bobricius/AtTiny85-Programming-Shield/README.md

AtTiny85-Programming-Shield
===========================

For HVSP programing you need externall 12V power and small wire between Attiny85 pin2 and Arduino D9
(bug on PCB)
