bobricius/AtTiny85-Programming-Shield/V1/ATTINYProgrammer.brd

## EAGLE design V1/ATTINYProgrammer.brd (2014-12-17)

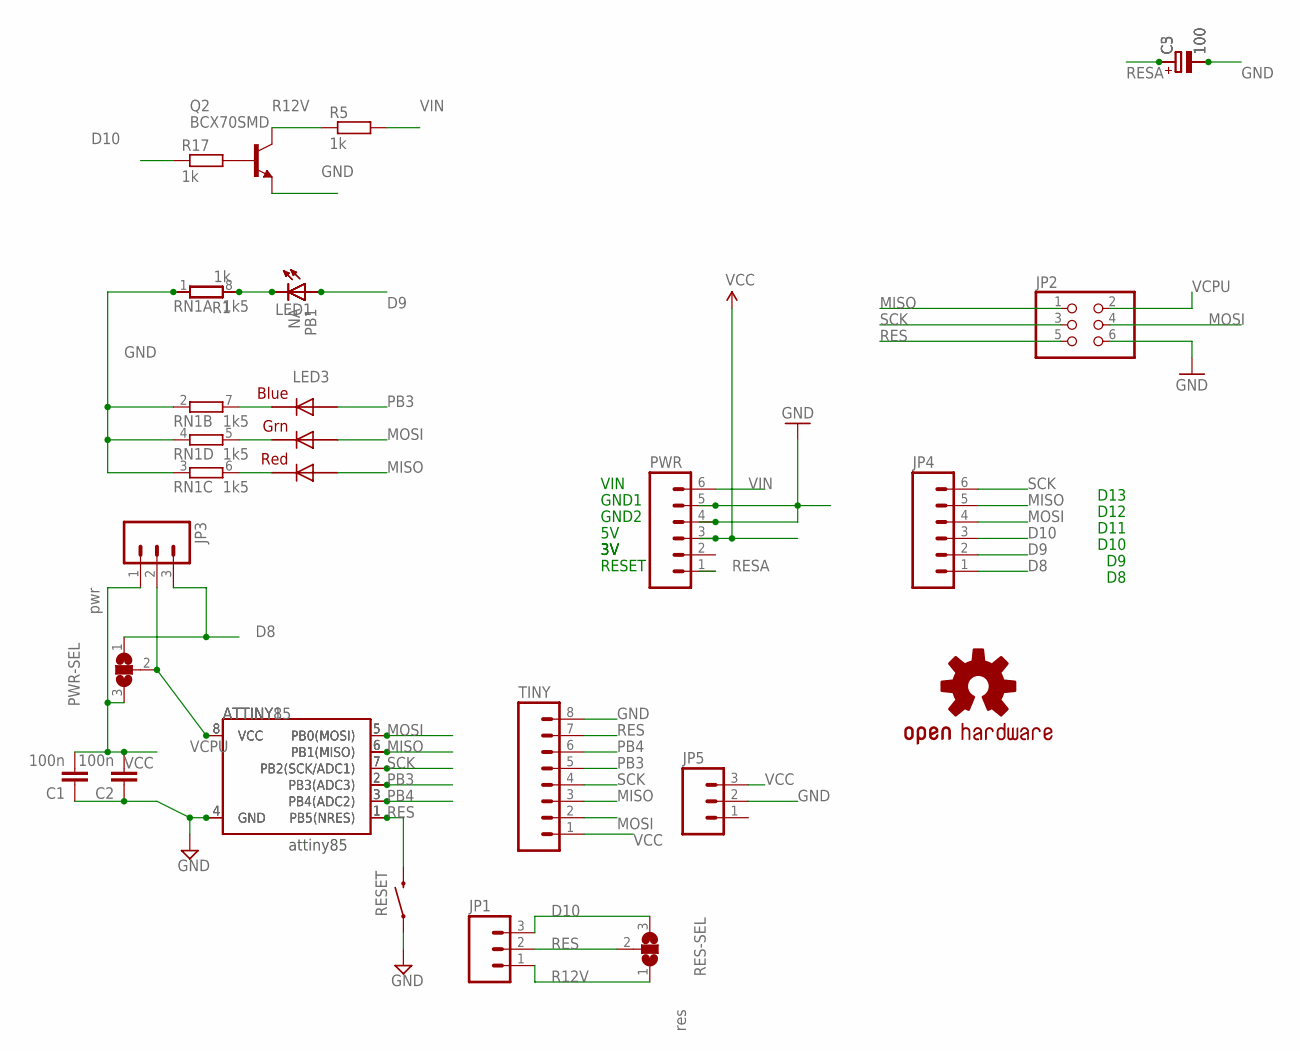
[picture p1: schematic ATTINYProgrammer.sch]

Parts:
ATTINY1: ATTINY45; SO08-EIAJ
ATTINY85: ATTINY45DIP8; DIP08
C1: 100n; C0603
C2: 100n; C025-024X044
C3: 100; TT2D4
C5: 100; 153CLV-0405
JP1, JP3: M03PTH; 1X03
JP2: PINHD-2X3; 2X03
JP4: M06LOCK; 1X06_LOCK
JP5: M03LOCK; 1X03_LOCK
LED1: LED3MM
LED3: RGBLED5050
PB1: NA; LED-0603
PWR: M06LOCK; 1X06_LOCK
PWR-SEL: pwr; SJ_2_SMALL
Q2: BCX70SMD; SOT23
R1: 1k; 0204/5@1
R5, R17: 1k; R0603
RES-SEL: res; SJ_2_SMALL
RESET: SWITCH-MOMENTARY-2-SMD-1101NE; TACTILE-SWITCH-1101NE
RN1: 1k5; 0603-ARC
TINY: M08LOCK; 1X08_LOCK
U$2: OSHW-LOGOS; OSHW-LOGO-S

Connections:
D8: JP3.3, JP4.1, PWR-SEL.1
D9: JP4.2, LED1.A, PB1.A
D10: JP1.3, JP4.3, R17.1, RES-SEL.3
GND: ATTINY1.4 (GND), ATTINY85.4 (GND), C1.1, C2.1, C3.-, C5.-, JP2.6, JP5.2, PWR.4, PWR.5, Q2.2 (E), R1.2, RESET.P$1 (1), RN1.1, RN1.2 (1), RN1.3 (1), RN1.4 (1), TINY.8
MISO: ATTINY1.6 (PB1(MISO)), ATTINY85.6 (PB1(MISO)), JP2.1, JP4.5, LED3.2 (RED_A), TINY.3
MOSI: ATTINY1.5 (PB0(MOSI)), ATTINY85.5 (PB0(MOSI)), JP2.4, JP4.4, LED3.1 (GREEN_A), TINY.2
unnamed: LED1.K (C), PB1.C, R1.1, RN1.8 (2)
unnamed: LED3.4 (BLUE_C), RN1.7 (2)
unnamed: LED3.6 (GREEN_C), RN1.5 (2)
unnamed: Q2.1 (B), R17.2
unnamed: LED3.5 (RED_C), RN1.6 (2)
PB3: ATTINY1.2 (PB3(ADC3)), ATTINY85.2 (PB3(ADC3)), LED3.3 (BLUE_A), TINY.5
PB4: ATTINY1.3 (PB4(ADC2)), ATTINY85.3 (PB4(ADC2)), TINY.6
R12V: JP1.1, Q2.3 (C), R5.1, RES-SEL.1
RES: ATTINY1.1 (PB5(NRES)), ATTINY85.1 (PB5(NRES)), JP1.2, JP2.5, RES-SEL.2, RESET.P$2 (2), TINY.7
RESA: C3.+, C5.+, PWR.1
SCK: ATTINY1.7 (PB2(SCK/ADC1)), ATTINY85.7 (PB2(SCK/ADC1)), JP2.3, JP4.6, TINY.4
VCC: C1.2, C2.2, JP3.1, JP5.3, PWR.3, PWR-SEL.3, TINY.1
VCPU: ATTINY1.8 (VCC), ATTINY85.8 (VCC), JP2.2, JP3.2, PWR-SEL.2
VIN: PWR.6, R5.2

Notes on the sheet:
RESET
GND2
GND1
VIN
D13
D12
D11
D10
attiny85

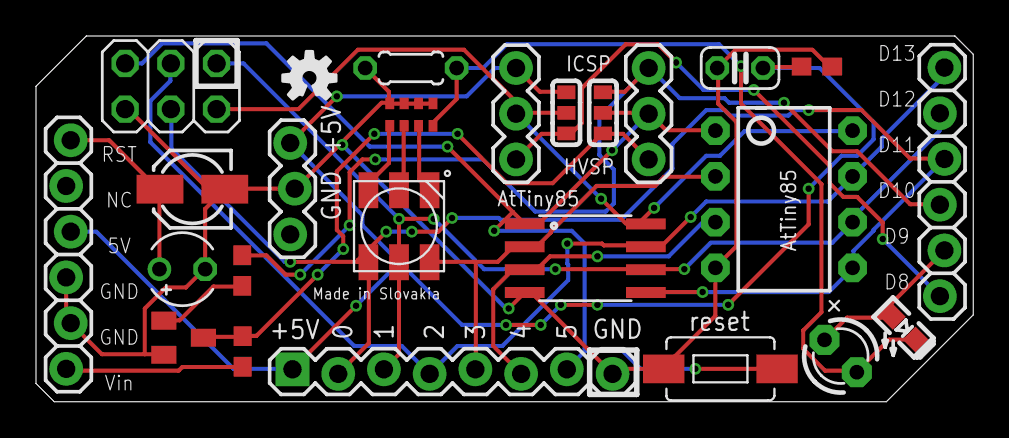
[picture p2: board ATTINYProgrammer.brd from above]

Board: 2 copper layers, 52.1 x 20.3 mm, 25 parts (0 on the bottom side), 20 nets.
